nguyentriet0810/xe_2_banh/App_dk/Resources/back.jpg

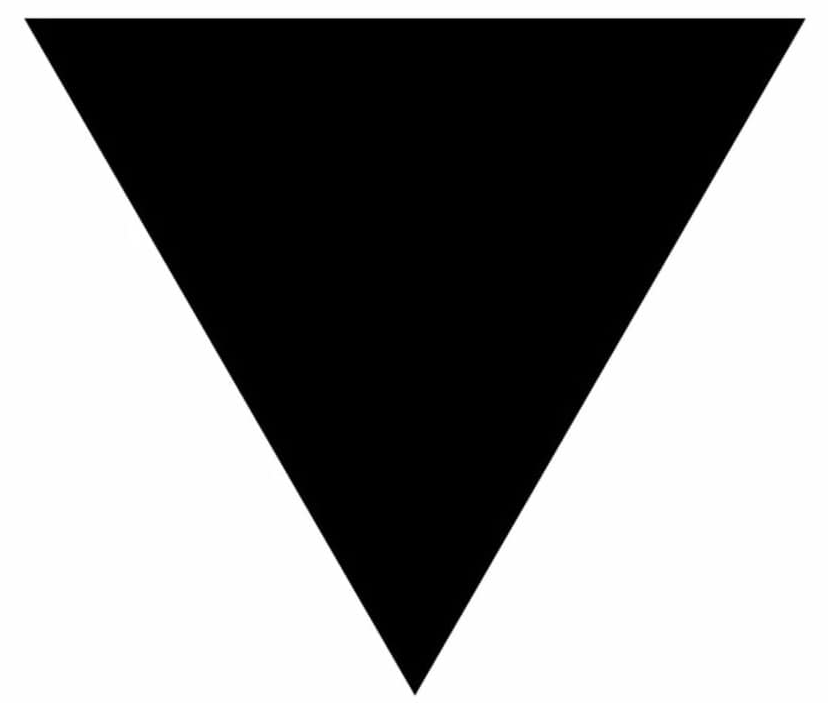
App_dk/Resources/back.jpg
