nguyentriet0810/xe_2_banh/App_dk/Resources/for.jpg

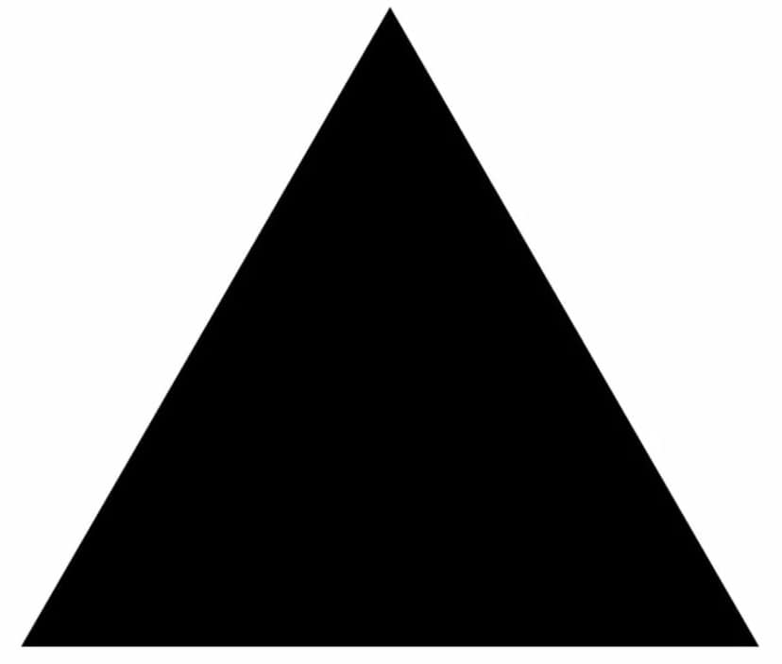
App_dk/Resources/for.jpg
