nguyentriet0810/xe_2_banh/App_dk/Resources/for.png

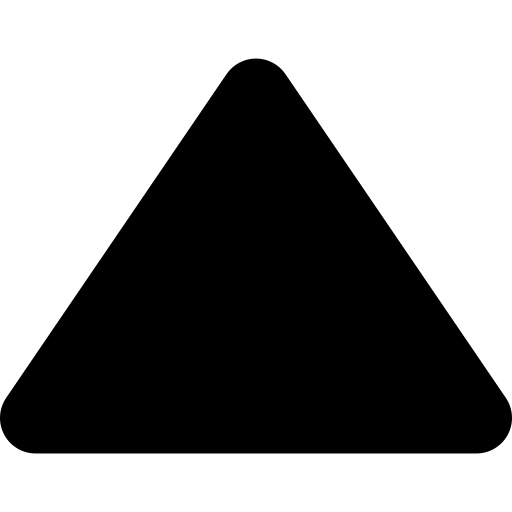
App_dk/Resources/for.png
