nguyentriet0810/xe_2_banh/App_dk/Resources/gallery_5908081.png

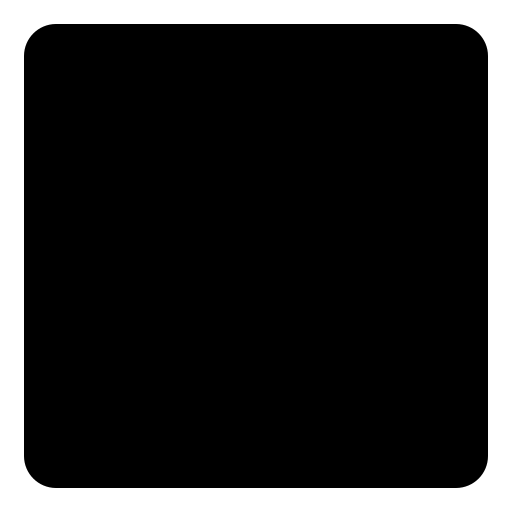
App_dk/Resources/gallery_5908081.png
