nguyentriet0810/xe_2_banh/App_dk/Resources/lest.png

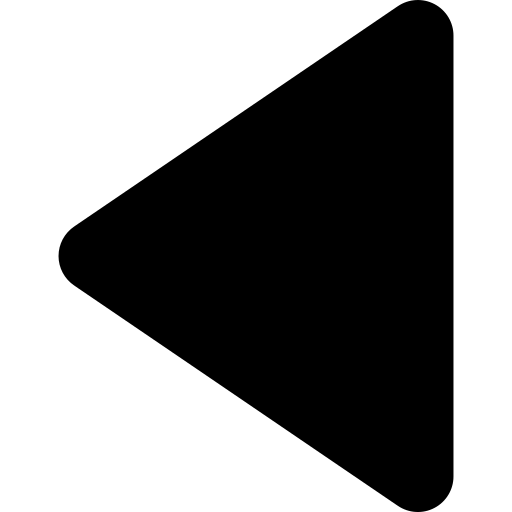
App_dk/Resources/lest.png
