nguyentriet0810/xe_2_banh/App_dk/Resources/play-button_1627551.png

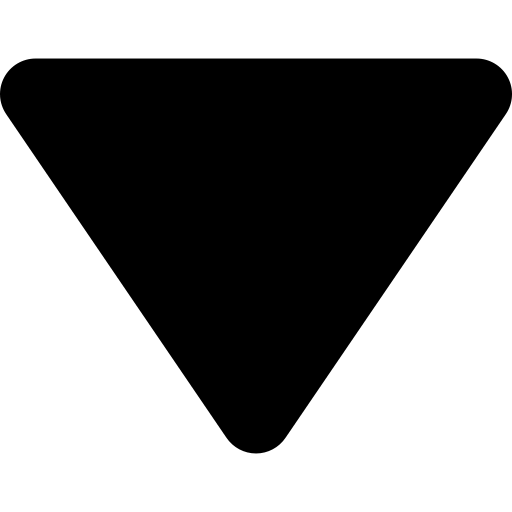
App_dk/Resources/play-button_1627551.png
