nguyentriet0810/xe_2_banh/App_dk/Resources/right.jpg

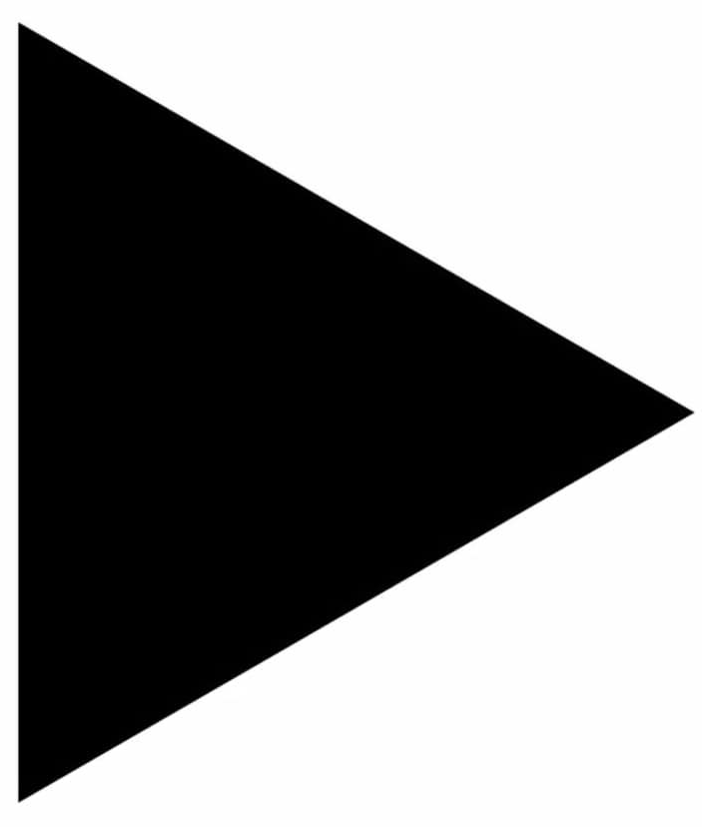
App_dk/Resources/right.jpg
